andrewrussellmalcolm/GPSRecorder/hardware/article/3d_model.png

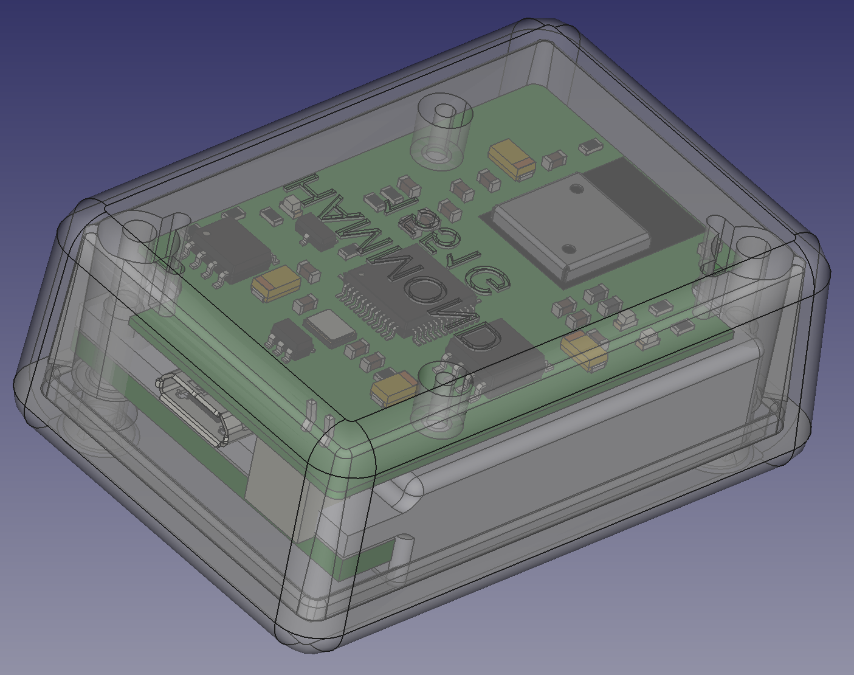
hardware/article/3d_model.png
