andrewrussellmalcolm/GPSRecorder/hardware/article/host_application .png

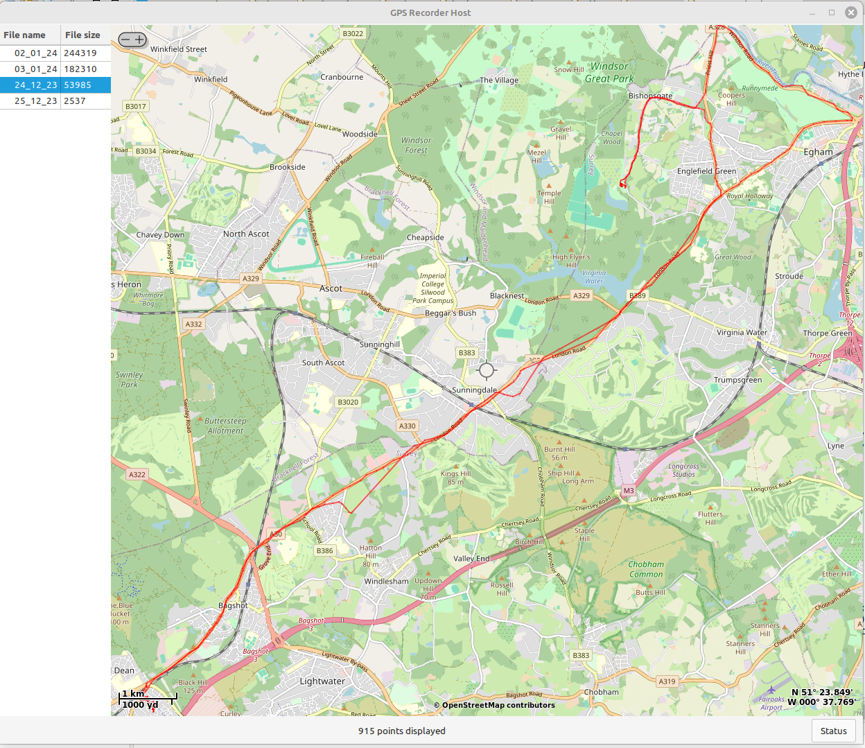
hardware/article/host_application .png
