andrewrussellmalcolm/GPSRecorder/hardware/article/command_line.png

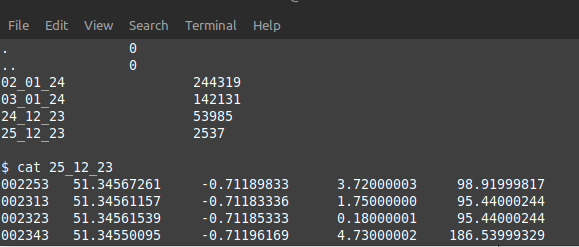
hardware/article/command_line.png
