andrewrussellmalcolm/GPSRecorder/hardware/article/data_flow.png

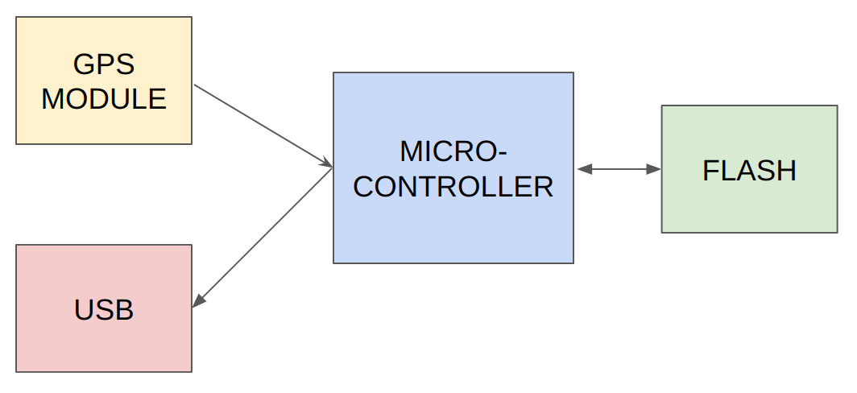
hardware/article/data_flow.png
