andrewrussellmalcolm/GPSRecorder/hardware/article/enclosure.png

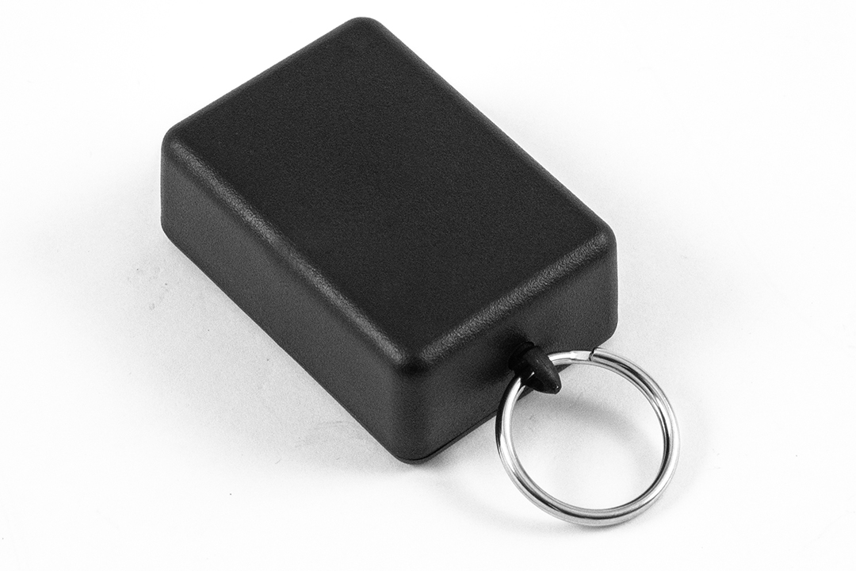
hardware/article/enclosure.png
