andrewrussellmalcolm/GPSRecorder/hardware/article/microcontroller_ configuration.png

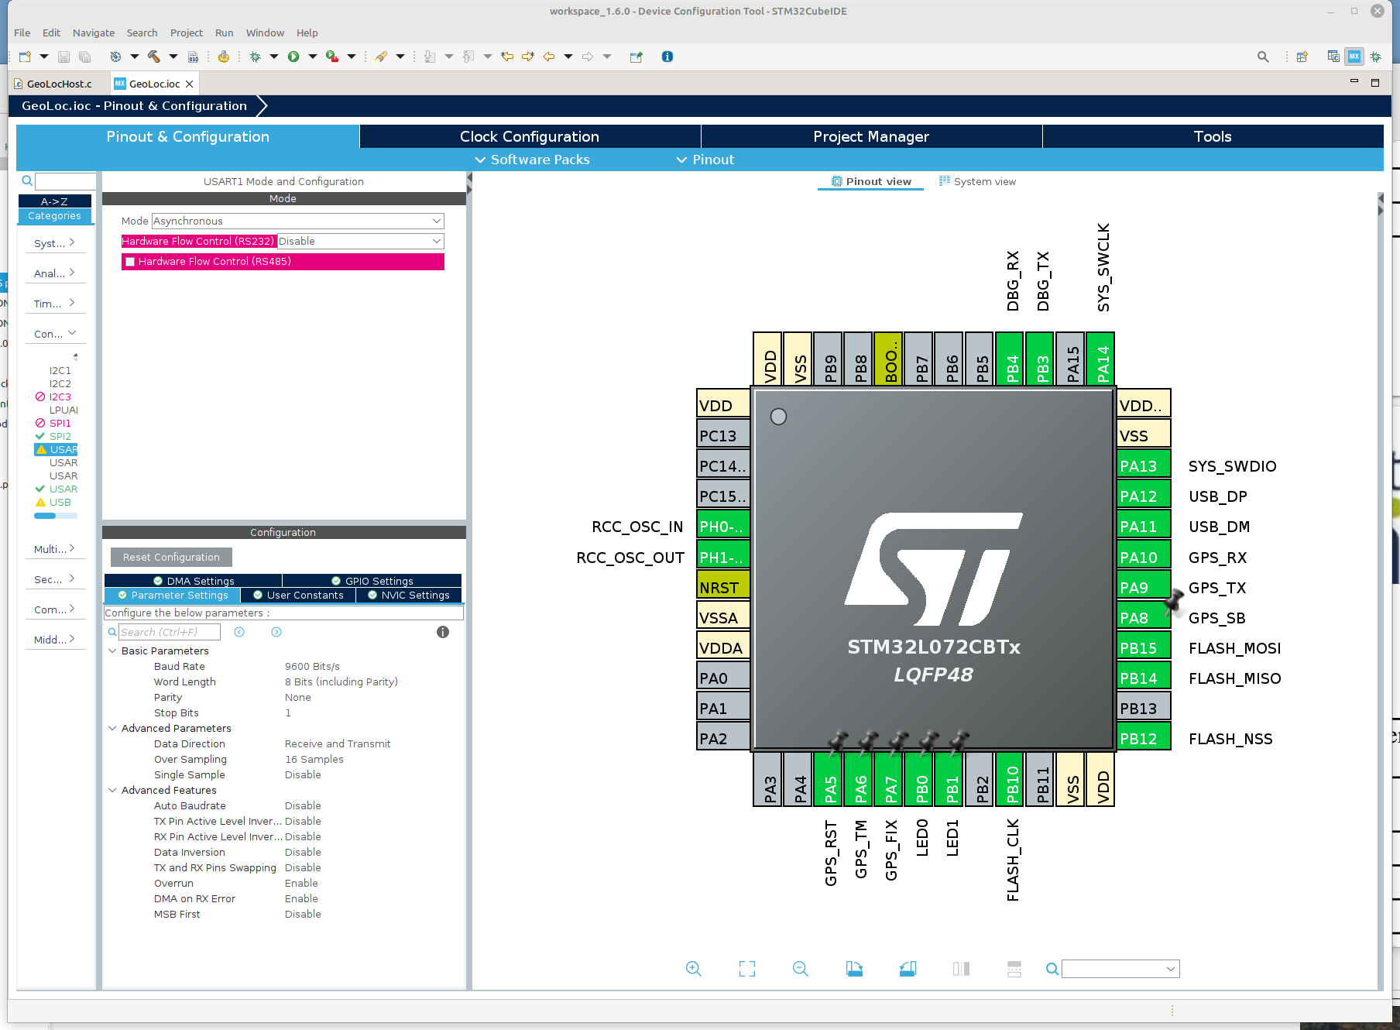
hardware/article/microcontroller_ configuration.png
