andrewrussellmalcolm/GPSRecorder/hardware/article/program_flow.png

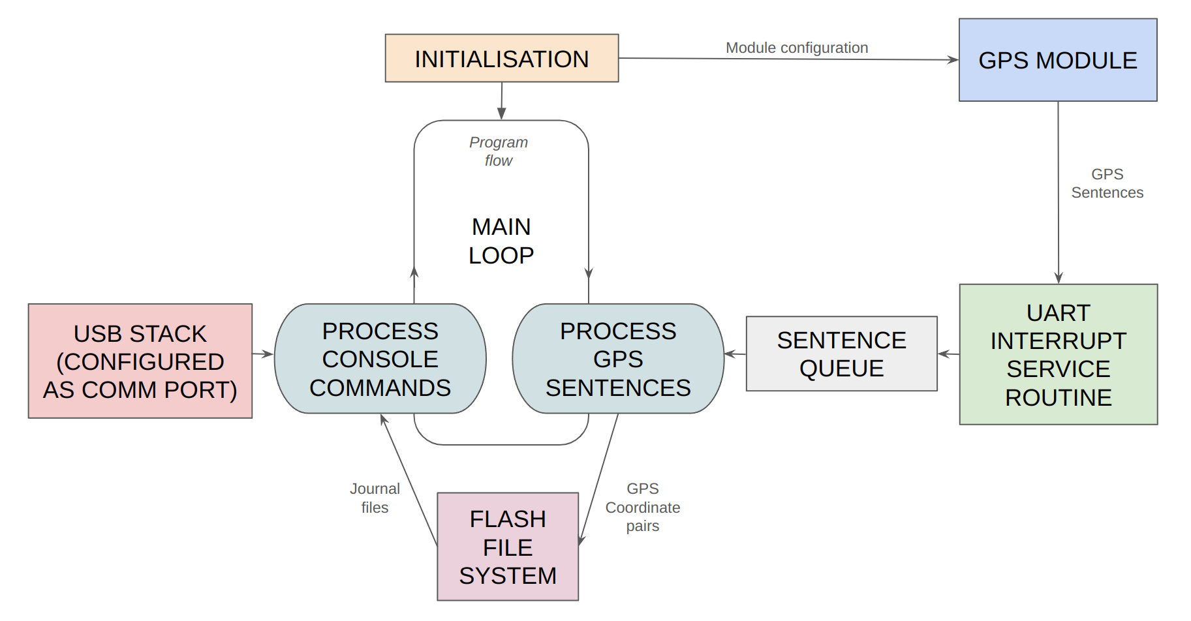
hardware/article/program_flow.png
