andrewrussellmalcolm/GPSRecorder/hardware/article/reset_home.png

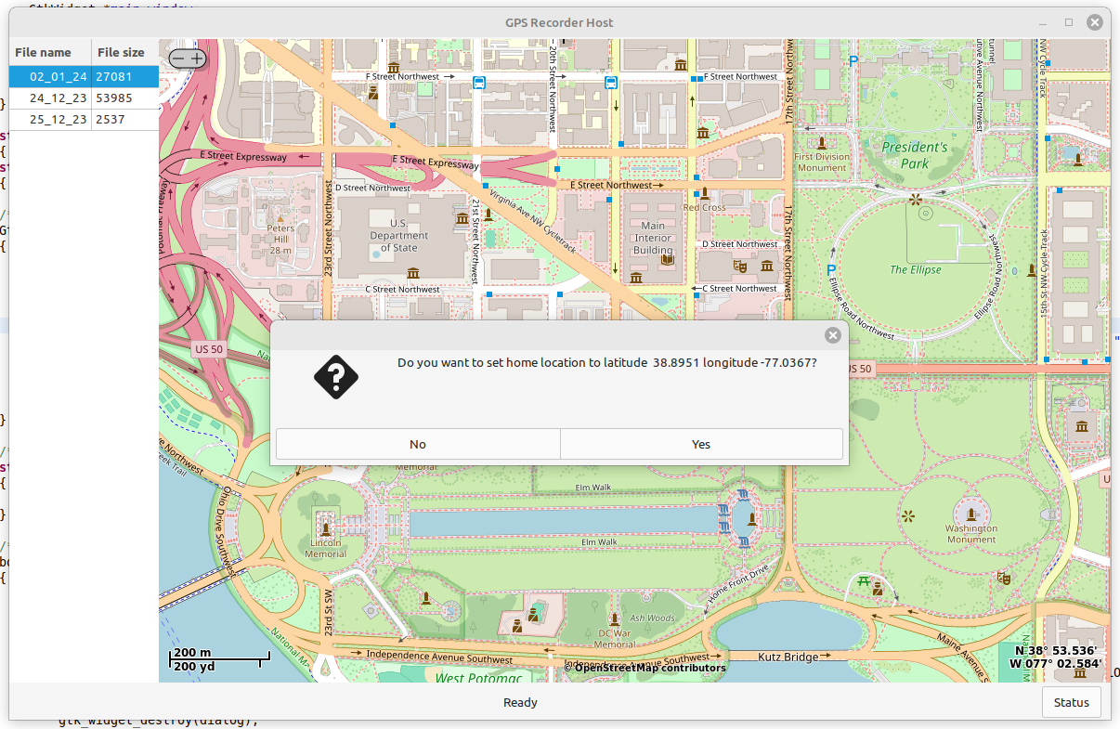
hardware/article/reset_home.png
