andrewrussellmalcolm/GPSRecorder/hardware/article/schematic.png

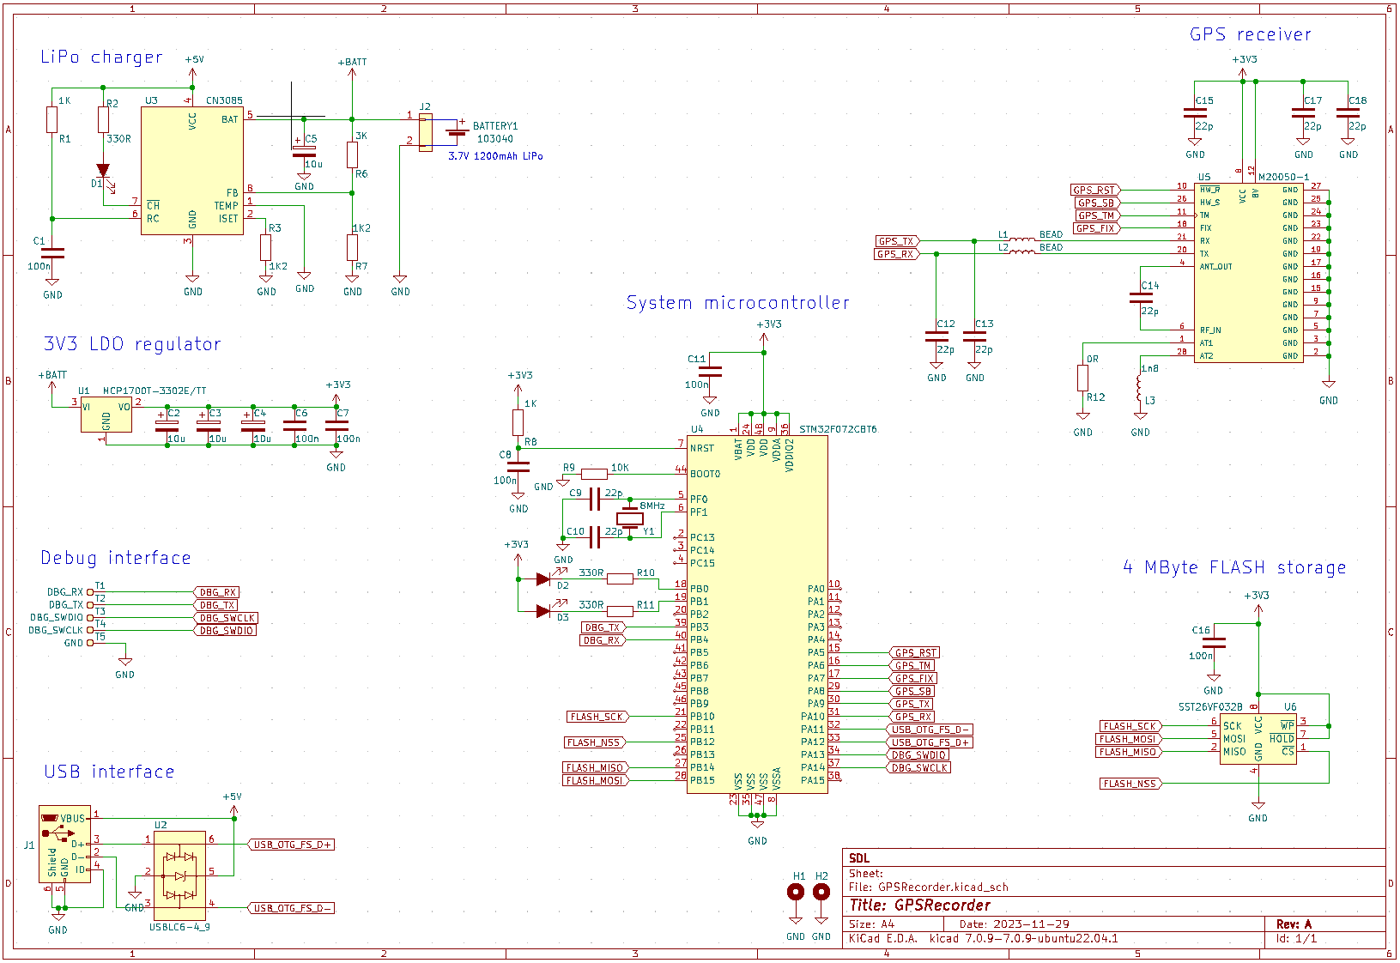
hardware/article/schematic.png
