andrewrussellmalcolm/GPSRecorder/hardware/article/status _screen.png

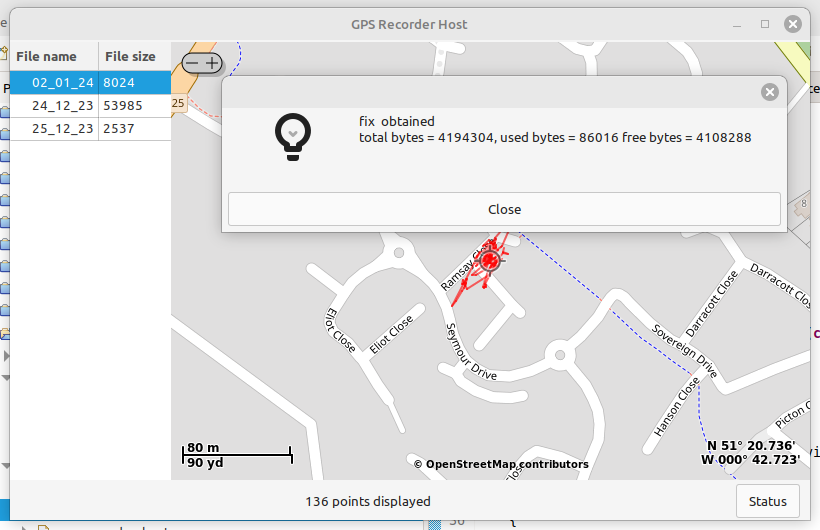
hardware/article/status _screen.png
