andrewrussellmalcolm/GPSRecorder/hardware/3D_models/GPSRecorder_Overall_Assy.FCStd

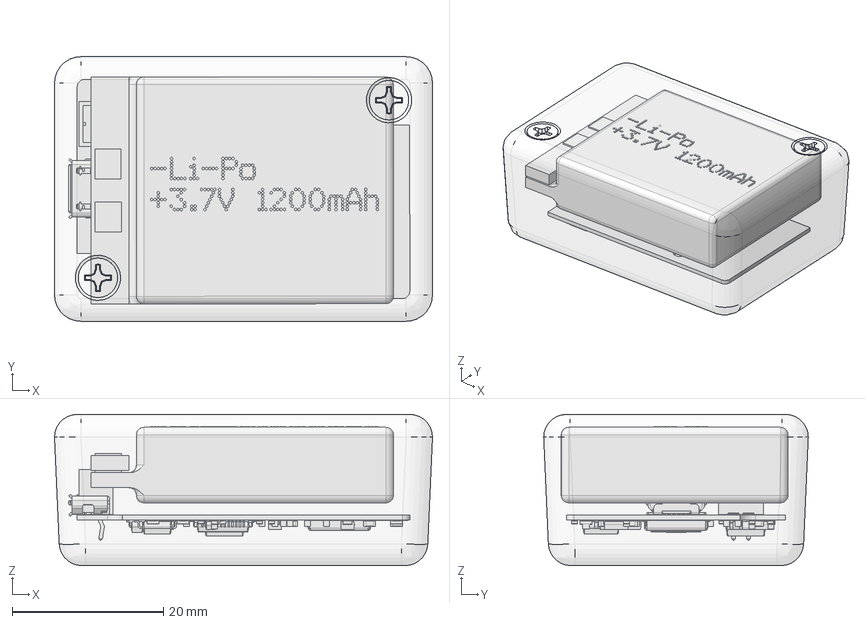
[picture p11: CAD file, 2024-01-20]
hardware/3D_models/GPSRecorder_Overall_Assy.FCStd
50.0 x 35.0 x 20.0 mm
Hammond_1551G_case_001
GPSRecorder_PCB_Assy_001
LiPo_Cell_103040_001
