andrewrussellmalcolm/GPSRecorder/hardware/3D_models/GPSRecorder_PCB_Assy.FCStd

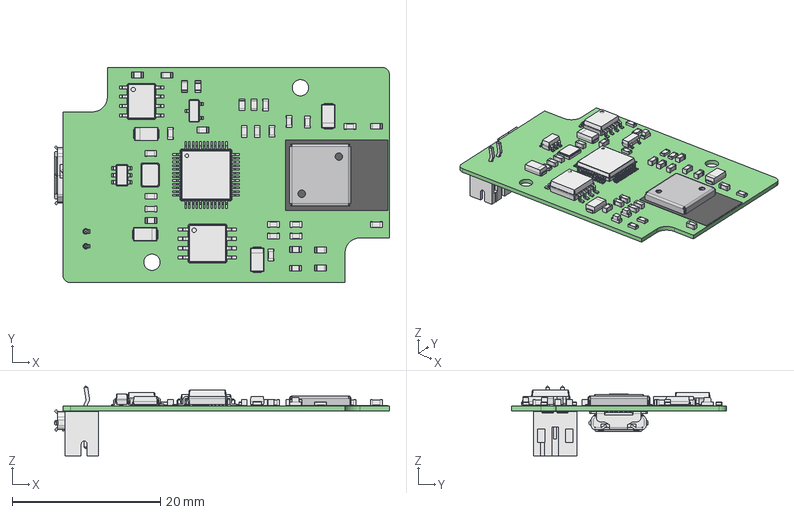
[picture p12: CAD file, 2024-01-20]
hardware/3D_models/GPSRecorder_PCB_Assy.FCStd
45.1 x 29.0 x 9.40 mm
GPSRecorder PCB
