andrewrussellmalcolm/GPSRecorder/hardware/3D_models/LiPo_Cell_103040.FCStd

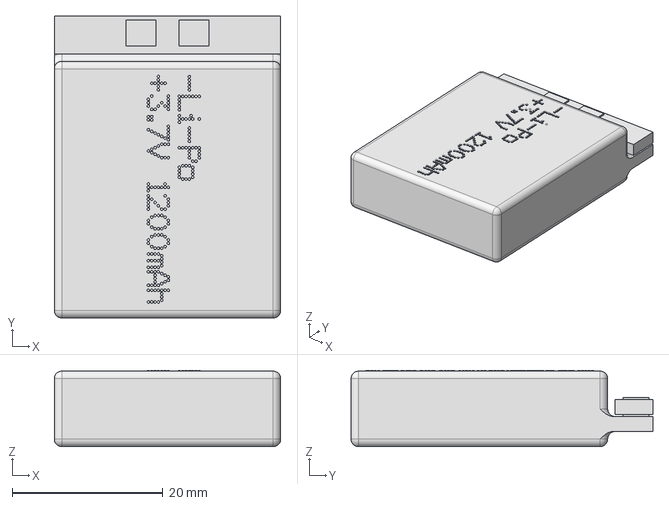
[picture p13: CAD file, 2024-01-20]
hardware/3D_models/LiPo_Cell_103040.FCStd
30.0 x 40.0 x 10.1 mm
