andrewrussellmalcolm/GPSRecorder/hardware/3D_models/1551G.stp

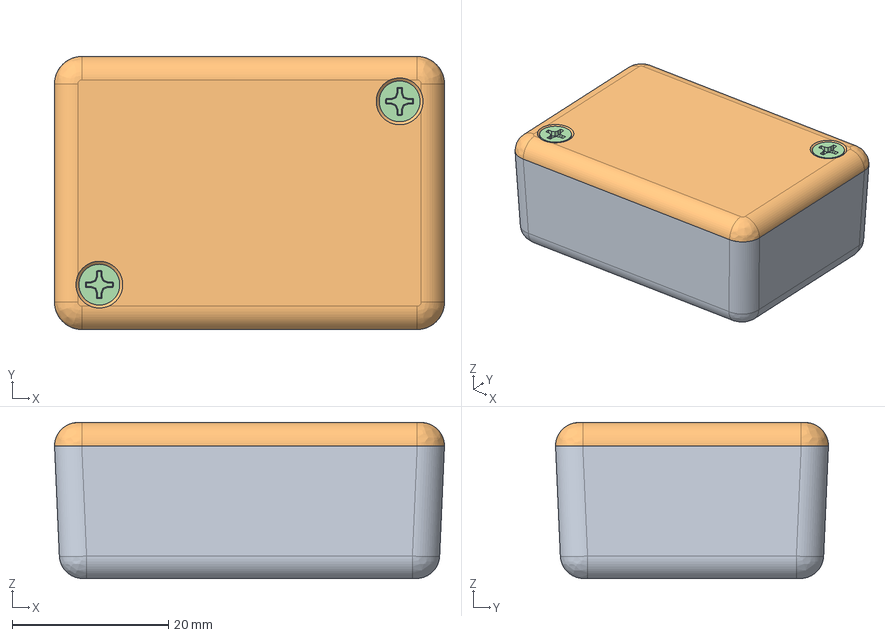
[picture p14: CAD file, 2024-01-20]
hardware/3D_models/1551G.stp
50.0 x 35.0 x 20.0 mm
1551G Box
1551F-G Lid
1551G PCB
