andrewrussellmalcolm/GPSRecorder/hardware/3D_models/Hammond_1551G_case.FCStd

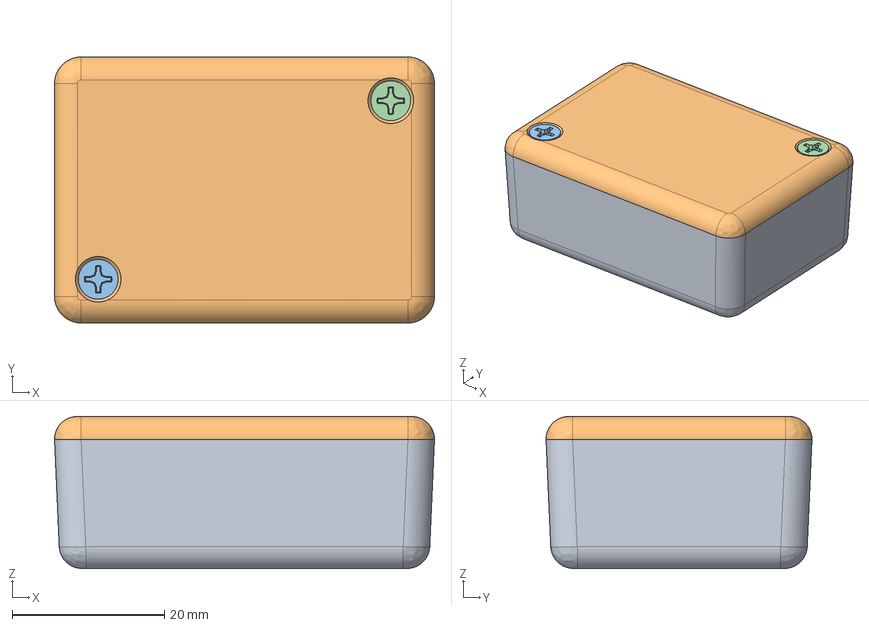
[picture p15: CAD file, 2024-01-20]
hardware/3D_models/Hammond_1551G_case.FCStd
50.0 x 35.0 x 20.0 mm
1551G Box
1551F-G Lid
SC510 (screw #4X 1_2'' FH)
SC510 (screw #4X 1_2'' FH)001
