andrewrussellmalcolm/GPSRecorder/hardware/3D_models/M20050-1_shieldingcan.step

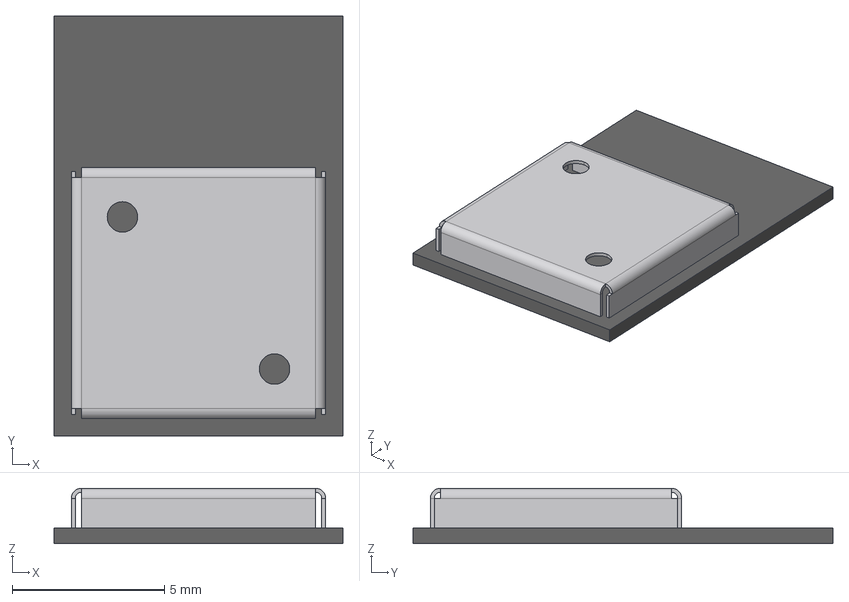
[picture p16: CAD file, 2024-01-20]
hardware/3D_models/M20050-1_shieldingcan.step
9.50 x 13.8 x 1.82 mm
