andrewrussellmalcolm/GPSRecorder/(list of files, cad)

Other CAD files:
hardware/3D_models/Li-Po 1200.stp
