andrewrussellmalcolm/GPSRecorder/hardware/GPSRecorder.kicad_pcb

## KiCad design hardware/GPSRecorder.kicad_pcb (2024-01-20)

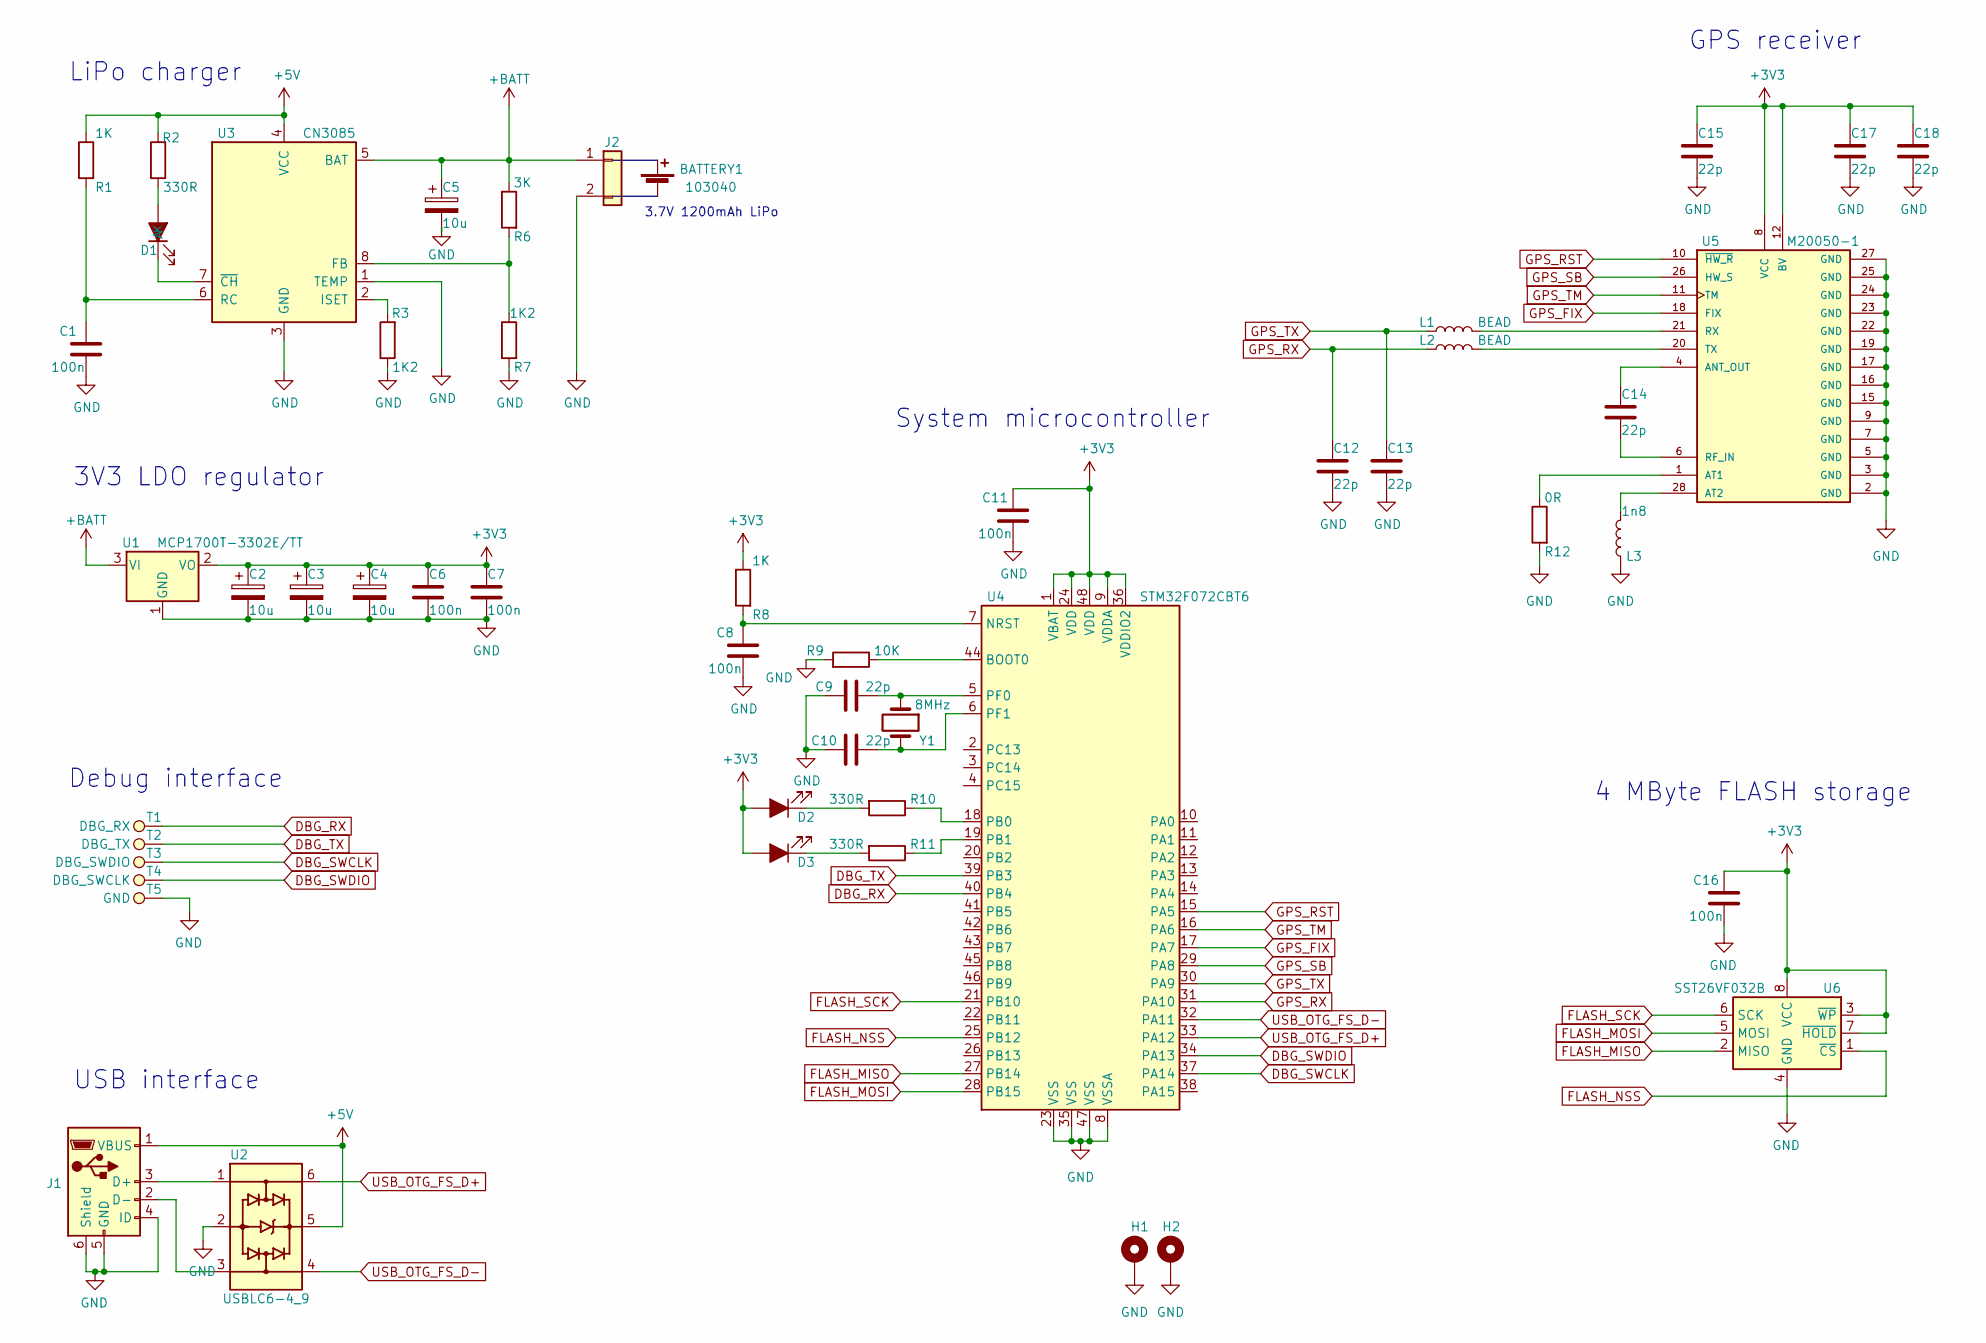
[picture p17: schematic GPSRecorder.kicad_sch]

Parts:
BATTERY1: 103040; dummy; Voltage 3; PartNo 97384022
C1, C8, C11, C16: 100n; C_0603_1608Metric; Voltage 50V; PartNo C0603C104K4RACTU
C2, C3, C4, C5: 10u; CP_EIA-3216-10_Kemet-I
C6, C7: 100n; C_0603_1608Metric
C9, C10: 22p; C_0603_1608Metric; Voltage 50V; PartNo C0603C220J5GACTU
C12, C13, C14, C15, C17, C18: 22p; C_0603_1608Metric; Voltage 50V; PartNo C0603C101J5GACTU
D1: LTST-C190KRKT; LED_0603_1608Metric
D2, D3: LED_RED; LED_0603_1608Metric; PartNo LS Q976
H1, H2: MountingHole_Pad; MountingHole_2.2mm_M2_Pad
J1: USB_OTG; USB_Micro-B_Molex_47346-0001; PartNo 105133-0011
J2: Conn_01x02; JST_PH_B2B-PH-K_1x02_P2.00mm_Vertical
L1, L2: BEAD; L_0603_1608Metric; PartNo LQW18AN2N2D00D
L3: 1n8; L_0603_1608Metric; PartNo LQW18AN2N2D00D
R1, R8: 1K; R_0603_1608Metric; PartNo CRG0603F1K
R2: 330R; R_0603_1608Metric
R3: 1K2; R_0603_1608Metric
R6: 3K; R_0603_1608Metric; PartNo CRG0603F1K
R7: 1K2; R_0603_1608Metric; PartNo CRG0603F1K
R9: 10K; R_0603_1608Metric; PartNo CRG0603F10K
R10, R11: 330R; R_0603_1608Metric; PartNo CRG0603F330R
R12: 0R; R_0603_1608Metric; PartNo CRG0603F10K
T1: DBG_RX; TestPoint_Pad_D2.0mm
T2: DBG_TX; TestPoint_Pad_D2.0mm
T3: DBG_SWDIO; TestPoint_Pad_D2.0mm
T4: DBG_SWCLK; TestPoint_Pad_D2.0mm
T5: GND; TestPoint_Pad_D2.0mm
U1: MCP1700T-3302E/TT; SOT-23
U2: USBLC6-4_9; SOT-23-6; PartNo USBLC6-2SC6Y
U3: CN3085; SOIC-8-1EP_3.9x4.9mm_P1.27mm_EP2.29x3mm
U4: STM32F072CBT6; LQFP-48_7x7mm_P0.5mm
U5: M20050-1; XCVR_M20050-1; PARTREV M20050-1-PS-2.01
U6: SST26VF032B; SOIC-8_5.275x5.275mm_P1.27mm; PartNo SST26VF032B-104I/SM
Y1: 8MHz; Crystal_SMD_Abracon_ABM8AIG-4Pin_3.2x2.5mm; PartNo ABM8AIG-8.000MHZ-8-V1R-T

Connections:
+3V3: C2.1, C3.1, C4.1, C6.1, C7.1, C11.2, C15.1, C16.2, C17.1, C18.1, D2.2 (A), D3.2 (A), R8.1, U1.2 (VO), U4.1 (VBAT), U4.9 (VDDA), U4.24 (VDD), U4.36 (VDDIO2), U4.48 (VDD), U5.8 (VCC), U5.12 (BV), U6.3 (~WP), U6.7 (~HOLD), U6.8 (VCC)
+5V: J1.1 (VBUS), R1.1, R2.2, U2.5, U3.4 (VCC)
+BATT: C5.1, J2.1, R6.1, U1.3 (VI), U3.5 (BAT)
DBG_RX: T1.1, U4.40 (PB4)
DBG_SWCLK: T3.1, U4.37 (PA14)
DBG_SWDIO: T4.1, U4.34 (PA13)
DBG_TX: T2.1, U4.39 (PB3)
FLASH_MISO: U4.27 (PB14), U6.2 (MISO)
FLASH_MOSI: U4.28 (PB15), U6.5 (MOSI)
FLASH_NSS: U4.25 (PB12), U6.1 (~CS)
FLASH_SCK: U4.21 (PB10), U6.6 (SCK)
GND: C1.1, C2.2, C3.2, C4.2, C5.2, C6.2, C7.2, C8.1, C9.2, C10.2, C11.1, C12.2, C13.2, C15.2, C16.1, C17.2, C18.2, H1.1, H2.1, J1.4 (ID), J1.5 (GND), J1.6 (Shield), J2.2, L3.1, R3.1, R7.2, R9.2, R12.2, T5.1, U1.1 (GND), U2.2, U3.1 (TEMP), U3.3 (GND), U4.8 (VSSA), U4.23 (VSS), U4.35 (VSS), U4.47 (VSS), U5.2 (GND), U5.3 (GND), U5.5 (GND), U5.7 (GND), U5.9 (GND), U5.15 (GND), U5.16 (GND), U5.17 (GND), U5.19 (GND), U5.22 (GND), U5.23 (GND), U5.24 (GND), U5.25 (GND), U5.27 (GND), U6.4 (GND)
GPS_FIX: U4.17 (PA7), U5.18 (FIX)
GPS_RST: U4.15 (PA5), U5.10 (~HW_R)
GPS_RX: C12.1, L2.1, U4.31 (PA10)
GPS_SB: U4.29 (PA8), U5.26 (HW_S)
GPS_TM: U4.16 (PA6), U5.11 (TM)
GPS_TX: C13.1, L1.1, U4.30 (PA9)
unnamed: C1.2, R1.2, U3.6 (RC)
unnamed: C8.2, R8.2, U4.7 (NRST)
unnamed: C9.1, U4.5 (PF0), Y1.1
unnamed: C10.1, U4.6 (PF1), Y1.3
unnamed: C14.1, U5.4 (ANT_OUT)
unnamed: C14.2, U5.6 (RF_IN)
unnamed: D1.1 (K), U3.7 (~CH)
unnamed: D1.2 (A), R2.1
unnamed: D2.1 (K), R10.2
unnamed: D3.1 (K), R11.2
unnamed: J1.2 (D-), U2.3
unnamed: J1.3 (D+), U2.1
unnamed: L1.2, U5.21 (RX)
unnamed: L2.2, U5.20 (TX)
unnamed: L3.2, U5.28 (AT2)
unnamed: R3.2, U3.2 (ISET)
unnamed: R6.2, R7.1, U3.8 (FB)
unnamed: R9.1, U4.44 (BOOT0)
unnamed: R10.1, U4.18 (PB0)
unnamed: R11.1, U4.19 (PB1)
unnamed: R12.1, U5.1 (AT1)
USB_OTG_FS_D+: U2.6, U4.33 (PA12)
USB_OTG_FS_D-: U2.4, U4.32 (PA11)

Notes on the sheet:
3V3 LDO regulator
LiPo charger
USB interface
4 MByte FLASH storage
System microcontroller
Debug interface
GPS receiver
3.7V 1200mAh LiPo

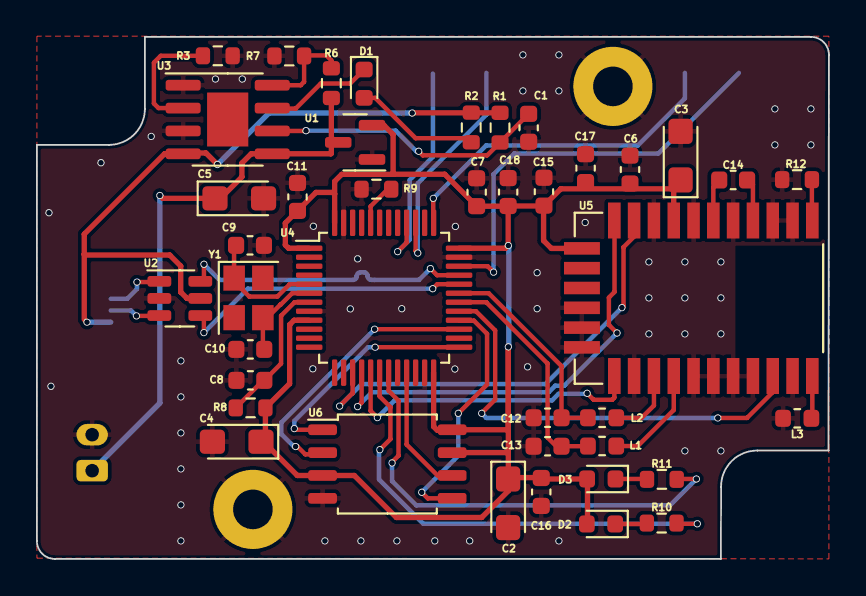
[picture p18: board GPSRecorder.kicad_pcb from above]

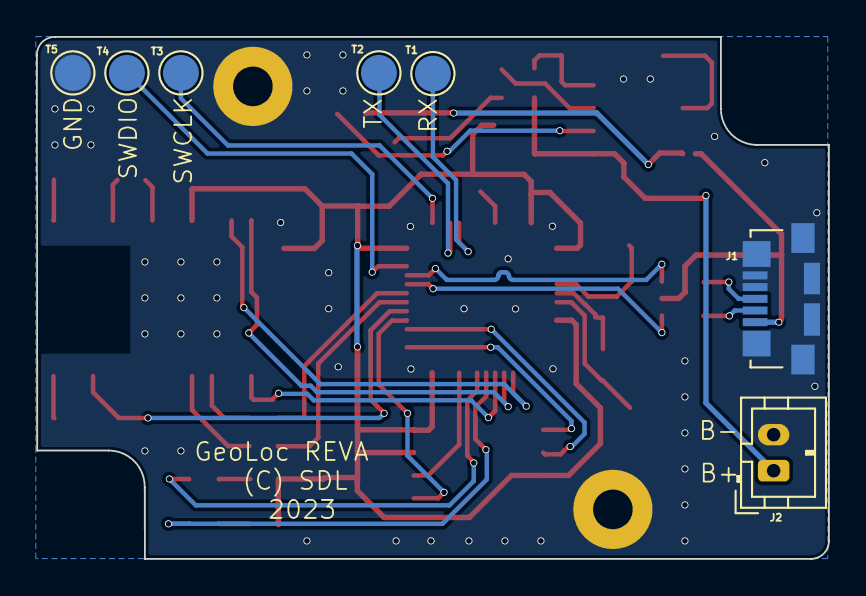
[picture p19: board GPSRecorder.kicad_pcb from below]

Board: 2 copper layers, 44.0 x 29.0 mm, 51 parts (8 on the bottom side), 41 nets.
