andrewrussellmalcolm/GPSRecorder/firmware/Core/Src/main.c

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
/* Includes ------------------------------------------------------------------*/
#include "main.h"
#include "usb_device.h"

RTC_HandleTypeDef hrtc;

SPI_HandleTypeDef hspi2;

UART_HandleTypeDef huart1;

void SystemClock_Config(void);
static void MX_GPIO_Init(void);
static void MX_SPI2_Init(void);
static void MX_RTC_Init(void);
static void MX_USART1_UART_Init(void);
/* USER CODE BEGIN PFP */
void main_task(void);
/* USER CODE END PFP */

/* USER CODE BEGIN 0 */
#include <stdio.h>
#include <sys/unistd.h>
#include "usbd_def.h"
#include "usbd_core.h"
#include "usbd_cdc_if.h"

// read from usb serial port
int _read(int file, char *data, int len)
{
	while(!usb_char_waiting())
	{
		HAL_Delay(10);
	}

    *data = usb_read_char();
	return 1;
}

// write to usb serial port
int _write(int file, char *ptr, int len)
{
	if(usb_is_configured())
	{
		usb_write_chars(ptr, len);
	}

	return len;
}
/* USER CODE END 0 */

/**
  * @brief  The application entry point.
  * @retval int
  */
int main(void)
{
  /* MCU Configuration--------------------------------------------------------*/

  /* Reset of all peripherals, Initializes the Flash interface and the Systick. */
  HAL_Init();

  /* Configure the system clock */
  SystemClock_Config();

  /* Initialize all configured peripherals */
  MX_GPIO_Init();
  MX_USB_DEVICE_Init();
  MX_SPI2_Init();
  MX_RTC_Init();
  MX_USART1_UART_Init();
  /* USER CODE BEGIN 2 */
  setvbuf(stdin, NULL, _IONBF, 0);
  setvbuf(stdout, NULL, _IONBF, 0);
  setvbuf(stderr, NULL, _IONBF, 0);

  /* USER CODE END 2 */

  /* Infinite loop */
  /* USER CODE BEGIN WHILE */
  while (1)
  {
	  for(int delay =0; delay < 50; delay++)
	  {
			if(usb_is_configured())
			{
				break;
			}
			HAL_Delay(100);
	  }
	  main_task();
    /* USER CODE END WHILE */

    /* USER CODE BEGIN 3 */
  }
  /* USER CODE END 3 */
}

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
