andrewrussellmalcolm/GPSRecorder/firmware/Core/Inc/main.h

#define CLS "\x1B[2J"
#define CLL "\x1B[2K"
#define kbhit usb_char_waiting
#define GPS_RST_Pin GPIO_PIN_5
#define GPS_RST_GPIO_Port GPIOA
#define GPS_TM_Pin GPIO_PIN_6
#define GPS_TM_GPIO_Port GPIOA
#define GPS_FIX_Pin GPIO_PIN_7
#define GPS_FIX_GPIO_Port GPIOA
#define LED0_Pin GPIO_PIN_0
#define LED0_GPIO_Port GPIOB
#define LED1_Pin GPIO_PIN_1
#define LED1_GPIO_Port GPIOB
#define FLASH_SCK_Pin GPIO_PIN_10
#define FLASH_SCK_GPIO_Port GPIOB
#define FLASH_NSS_Pin GPIO_PIN_12
#define FLASH_NSS_GPIO_Port GPIOB
#define FLASH_MISO_Pin GPIO_PIN_14
#define FLASH_MISO_GPIO_Port GPIOB
#define FLASH_MOSI_Pin GPIO_PIN_15
#define FLASH_MOSI_GPIO_Port GPIOB
#define GPS_SB_Pin GPIO_PIN_8
#define GPS_SB_GPIO_Port GPIOA
#define GPS_TX_Pin GPIO_PIN_9
#define GPS_TX_GPIO_Port GPIOA
#define GPS_RX_Pin GPIO_PIN_10
#define GPS_RX_GPIO_Port GPIOA
