andrewrussellmalcolm/GPSRecorder/firmware/Core/Inc/console.h

/*
 * console.h
 *
 *  Created on: 25 Nov 2021
 *      Author: andrew
 */

#ifndef INC_CONSOLE_H_
#define INC_CONSOLE_H_

void console_init(void);
void console_process_key(void);
#endif /* INC_CONSOLE_H_ */
